chenxuuu/eink-calendar-server/shell.FCStd

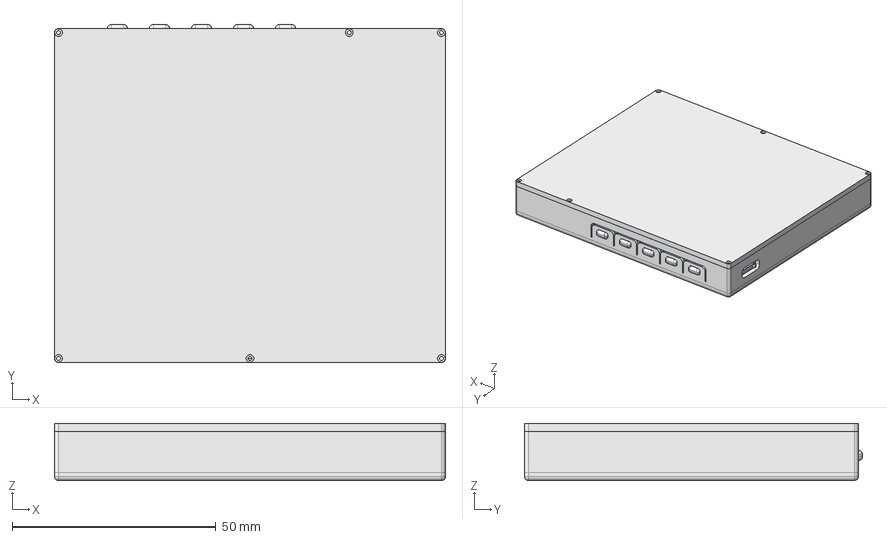
[picture p1: CAD file, 2021-05-28]
shell.FCStd
96.0 x 83.0 x 14.0 mm
under001
font001
