chenxuuu/eink-calendar-server/Eink-Air724/la-pi.kicad_pcb

## KiCad design Eink-Air724/la-pi.kicad_pcb (2021-07-12)

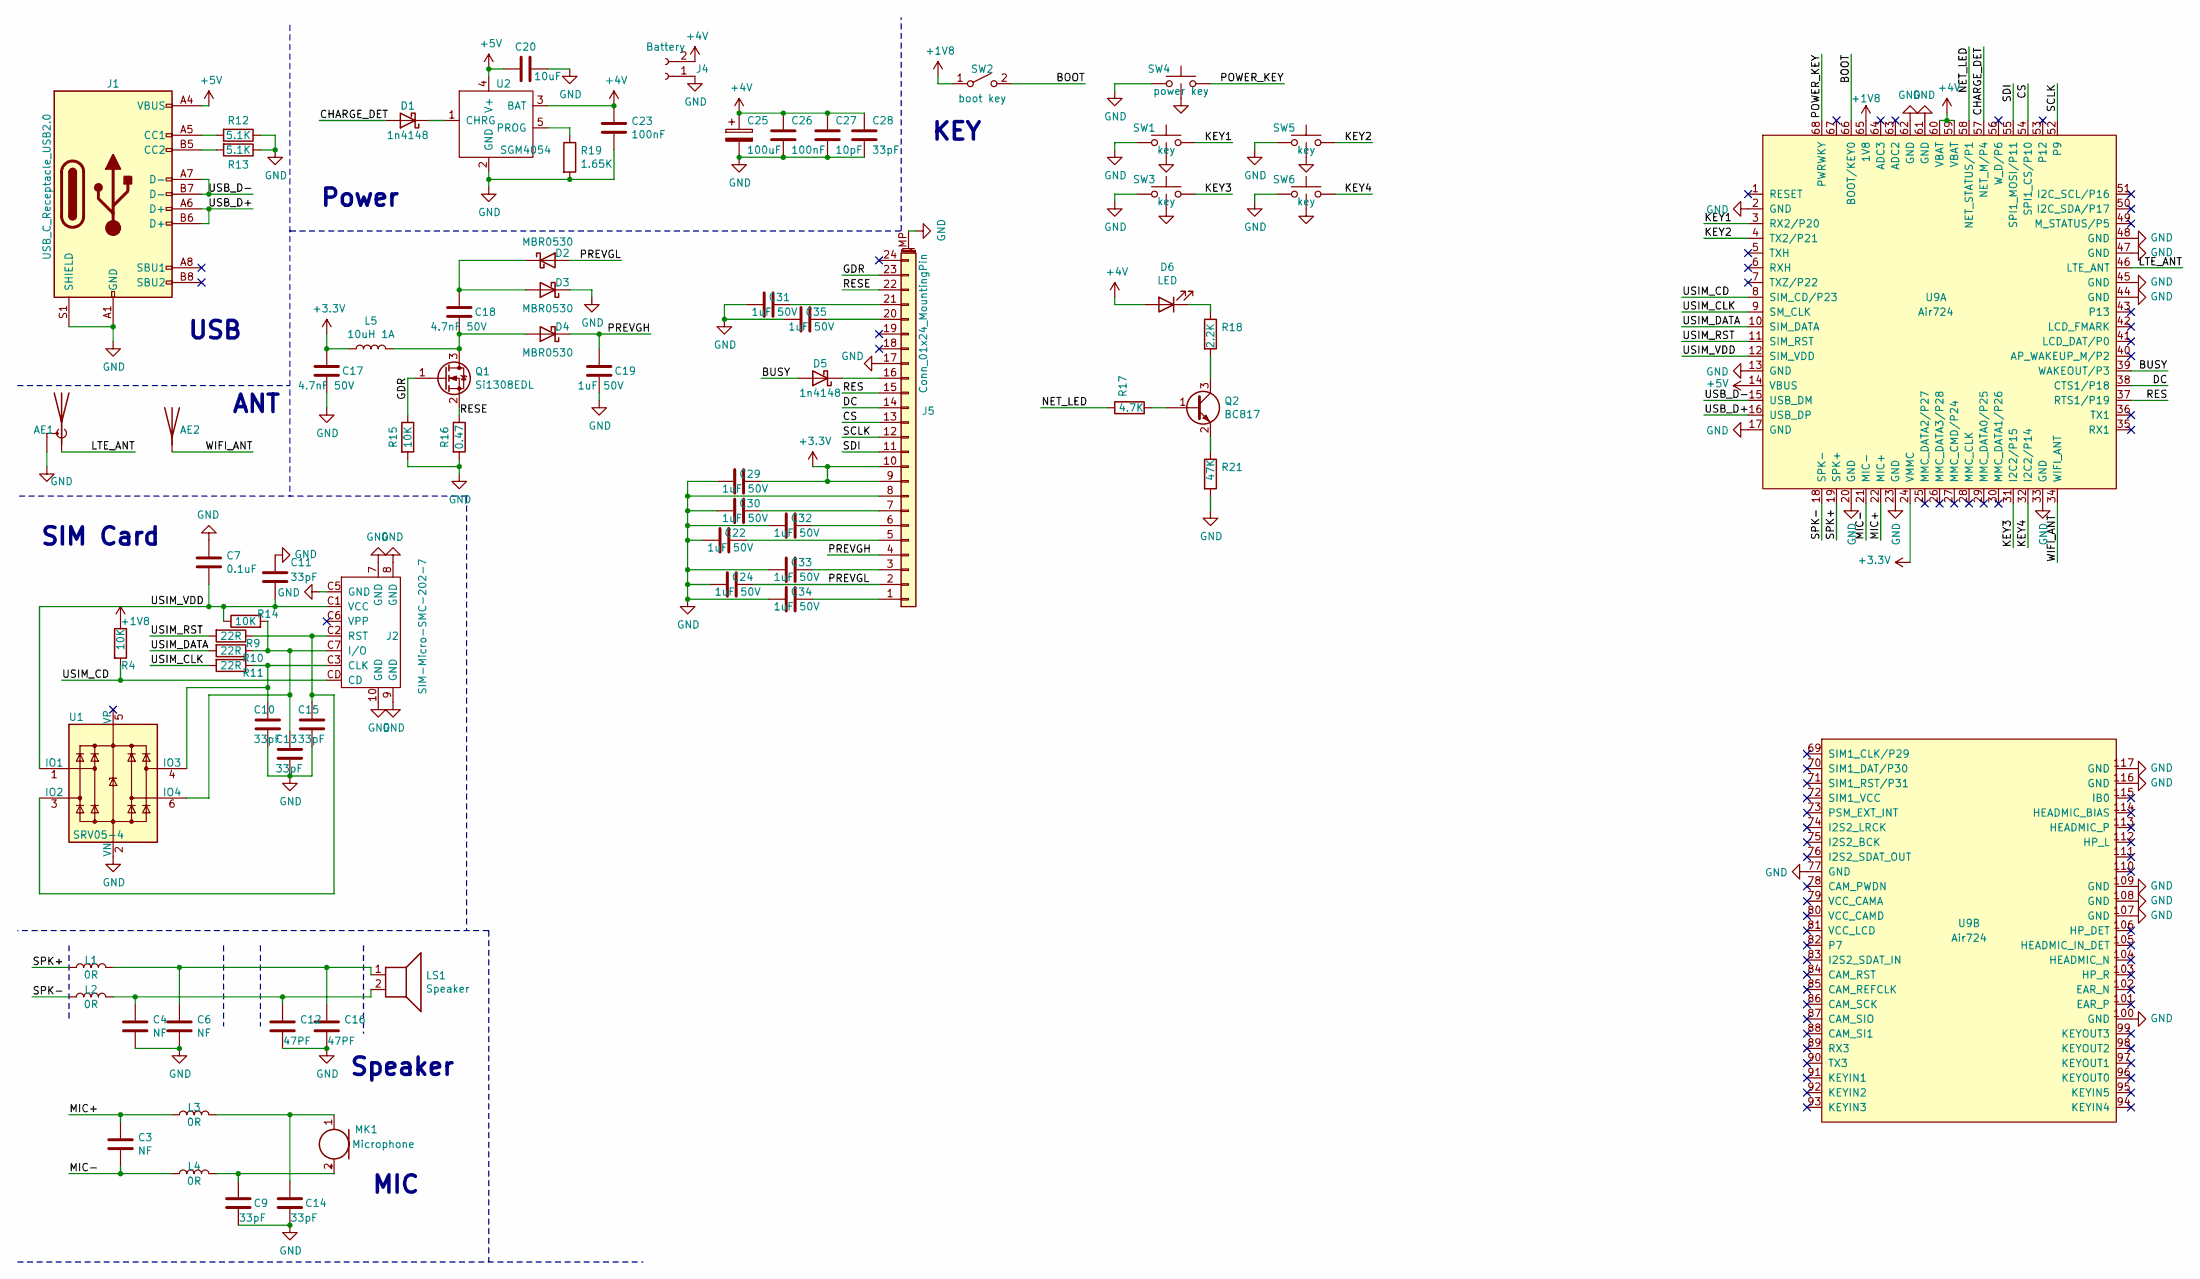
[picture p2: schematic la-pi.sch, La Pi]

Parts:
AE1: Antenna; IPEX
AE2: Antenna; Wifi_2.4GHz
C3, C4, C6: NF; C_0402_1005Metric
C7: 0.1uF; C_0402_1005Metric
C9, C10, C11, C13, C14, C15: 33pF; C_0402_1005Metric
C12, C16: 47PF; C_0402_1005Metric
C17, C18: 4.7nF 50V; C_0402_1005Metric
C19, C22, C24, C29, C30, C31, C32, C33, C34, C35: 1uF 50V; C_0402_1005Metric
C20: 10uF; C_0402_1005Metric
C23, C26: 100nF; C_0402_1005Metric
C25: 100uF; CP_EIA-1608-10_AVX-L_Pad1.25x1.05mm_HandSolder
C27: 10pF; C_0603_1608Metric
C28: 33pF; C_0603_1608Metric
D1, D5: 1n4148; D_SOD-323
D2, D3, D4: MBR0530; D_SOD-123
D6: LED; LED_0402_1005Metric
J1: USB_C_Receptacle_USB2.0; USB_C_Receptacle_HRO_TYPE-C-31-M-12
J2: SIM-Micro-SMC-202-7; SIM-SMD_SMC-202-7
J4: Battery; 2pin
J5: Conn_01x24_MountingPin; GDEW042T2
L1, L2, L3, L4: 0R; R_0402_1005Metric
L5: 10uH 1A; L_Bourns-SRN4018
LS1: Speaker; 2pin
MK1: Microphone; MIC-TH_BD4.0-P1.40-D0.4-L-FD
Q1: Si1308EDL; SOT-323_SC-70
Q2: BC817; SOT-23
R4, R14, R15: 10K; R_0402_1005Metric
R9, R10, R11: 22R; R_0402_1005Metric
R12, R13: 5.1K; R_0402_1005Metric
R16: 0.47; R_0402_1005Metric
R17: 4.7K; R_0402_1005Metric
R18: 2.2K; R_0402_1005Metric
R19: 1.65K; R_0402_1005Metric
R21: 47K; R_0402_1005Metric
SW1, SW3, SW5, SW6: key; KEY-01
SW2: boot key; 2pin
SW4: power key; KEY-01
U1: SRV05-4; SOT-23-6
U2: SGM4054; SOT-23-5
U9: Air724

Connections:
+1V8: R4.1, SW2.1 (A), U9.65 (1V8)
+3V3: C17.1, C29.2, J5.9, J5.10, L5.1, U9.24 (VMMC)
+4V: C23.1, C25.1, C26.1, C27.1, C28.1, D6.2 (A), J4.2, U2.3 (BAT), U9.59 (VBAT), U9.60 (VBAT)
+5V: C20.2, J1.A4 (VBUS), J1.A9 (VBUS), J1.B4 (VBUS), J1.B9 (VBUS), U2.4 (V+), U9.14 (VBUS)
/BOOT: SW2.2 (B), U9.66 (BOOT/KEY0)
/BUSY: D5.2 (A), U9.39 (WAKEOUT/P3)
/CHARGE_DET: D1.2 (A), U9.57 (NET_M/P4)
/CS: J5.13, U9.54 (SPI1_CS/P10)
/DC: J5.14, U9.38 (CTS1/P18)
/GDR: J5.23, Q1.1 (G), R15.1
/KEY1: SW1.2, U9.3 (RX2/P20)
/KEY2: SW5.2, U9.4 (TX2/P21)
/KEY3: SW3.2, U9.31 (I2C2/P15)
/KEY4: SW6.2, U9.32 (I2C2/P14)
/LTE_ANT: AE1.1 (A), U9.46 (LTE_ANT)
/MIC+: C3.1, L3.1, U9.22 (MIC+)
/MIC-: C3.2, L4.1, U9.21 (MIC-)
/NET_LED: R17.1, U9.58 (NET_STATUS/P1)
/POWER_KEY: SW4.2, U9.68 (PWRWKY)
/PREVGH: C19.1, D4.1 (K), J5.4
/PREVGL: C24.2, D2.2 (A), J5.2
/RES: J5.15, U9.37 (RTS1/P19)
/RESE: J5.22, Q1.2 (S), R16.1
/SCLK: J5.12, U9.52 (P9)
/SDI: J5.11, U9.55 (SPI1_MOSI/P11)
/SPK+: L1.1, U9.19 (SPK+)
/SPK-: L2.1, U9.18 (SPK-)
/USB_D+: J1.A6 (D+), J1.B6 (D+), U9.16 (USB_DP)
/USB_D-: J1.A7 (D-), J1.B7 (D-), U9.15 (USB_DM)
/USIM_CD: J2.CD, R4.2, U9.8 (SIM_CD/P23)
/USIM_CLK: R11.2, U9.9 (SM_CLK)
/USIM_DATA: R10.2, U9.10 (SIM_DATA)
/USIM_RST: R9.2, U9.11 (SIM_RST)
/USIM_VDD: C7.2, C11.2, J2.C1 (VCC), R14.1, U1.1 (IO1), U9.12 (SIM_VDD)
/WIFI_ANT: AE2.1, U9.34 (WIFI_ANT)
GND: AE1.2 (Shield), C4.2, C6.2, C7.1, C9.2, C10.2, C11.1, C12.2, C13.2, C14.2, C15.2, C16.2, C17.2, C19.2, C20.1, C22.1, C23.2, C24.1, C25.2, C26.2, C27.2, C28.2, C29.1, C30.1, C31.1, C32.1, C33.1, C34.1, C35.1, D3.1 (K), J1.A1 (GND), J1.A12 (GND), J1.B1 (GND), J1.B12 (GND), J1.S1 (SHIELD), J2.7 (GND), J2.8 (GND), J2.9 (GND), J2.10 (GND), J2.C5 (GND), J4.1, J5.8, J5.17, J5.MP (MountPin), R12.1, R13.1, R15.2, R16.2, R19.2, R21.2, SW1.1, SW1.3 (GND), SW3.1, SW3.3 (GND), SW4.1, SW4.3 (GND), SW5.1, SW5.3 (GND), SW6.1, SW6.3 (GND), U1.2 (VN), U2.2 (GND), U9.2 (GND), U9.13 (GND), U9.17 (GND), U9.20 (GND), U9.23 (GND), U9.33 (GND), U9.44 (GND), U9.45 (GND), U9.47 (GND), U9.48 (GND), U9.61 (GND), U9.62 (GND), U9.77 (GND), U9.100 (GND), U9.107 (GND), U9.108 (GND), U9.109 (GND), U9.116 (GND), U9.117 (GND)
unnamed: C9.1, L4.2, MK1.2 (+)
unnamed: C10.1, J2.C3 (CLK), R11.1, U1.4 (IO3)
unnamed: C4.1, C12.1, L2.2, LS1.2
unnamed: C13.1, J2.C7 (I/O), R10.1, R14.2, U1.6 (IO4)
unnamed: C14.1, L3.2, MK1.1 (-)
unnamed: C15.1, J2.C2 (RST), R9.1, U1.3 (IO2)
unnamed: C6.1, C16.1, L1.2, LS1.1
unnamed: C18.1, D2.1 (K), D3.2 (A)
unnamed: C18.2, D4.2 (A), L5.2, Q1.3 (D)
unnamed: C22.2, J5.5
unnamed: C30.2, J5.7
unnamed: C31.2, J5.21
unnamed: C32.2, J5.6
unnamed: C33.2, J5.3
unnamed: C34.2, J5.1
unnamed: C35.2, J5.20
unnamed: D1.1 (K), U2.1 (CHRG)
unnamed: D5.1 (K), J5.16
unnamed: D6.1 (K), R18.1
unnamed: J1.A5 (CC1), R12.2
unnamed: J1.B5 (CC2), R13.2
unnamed: Q2.1 (B), R17.2
unnamed: Q2.2 (E), R21.1
unnamed: Q2.3 (C), R18.2
unnamed: R19.1, U2.5 (PROG)

Notes on the sheet:
USB
Power
ANT
SIM Card
Speaker
MIC
KEY

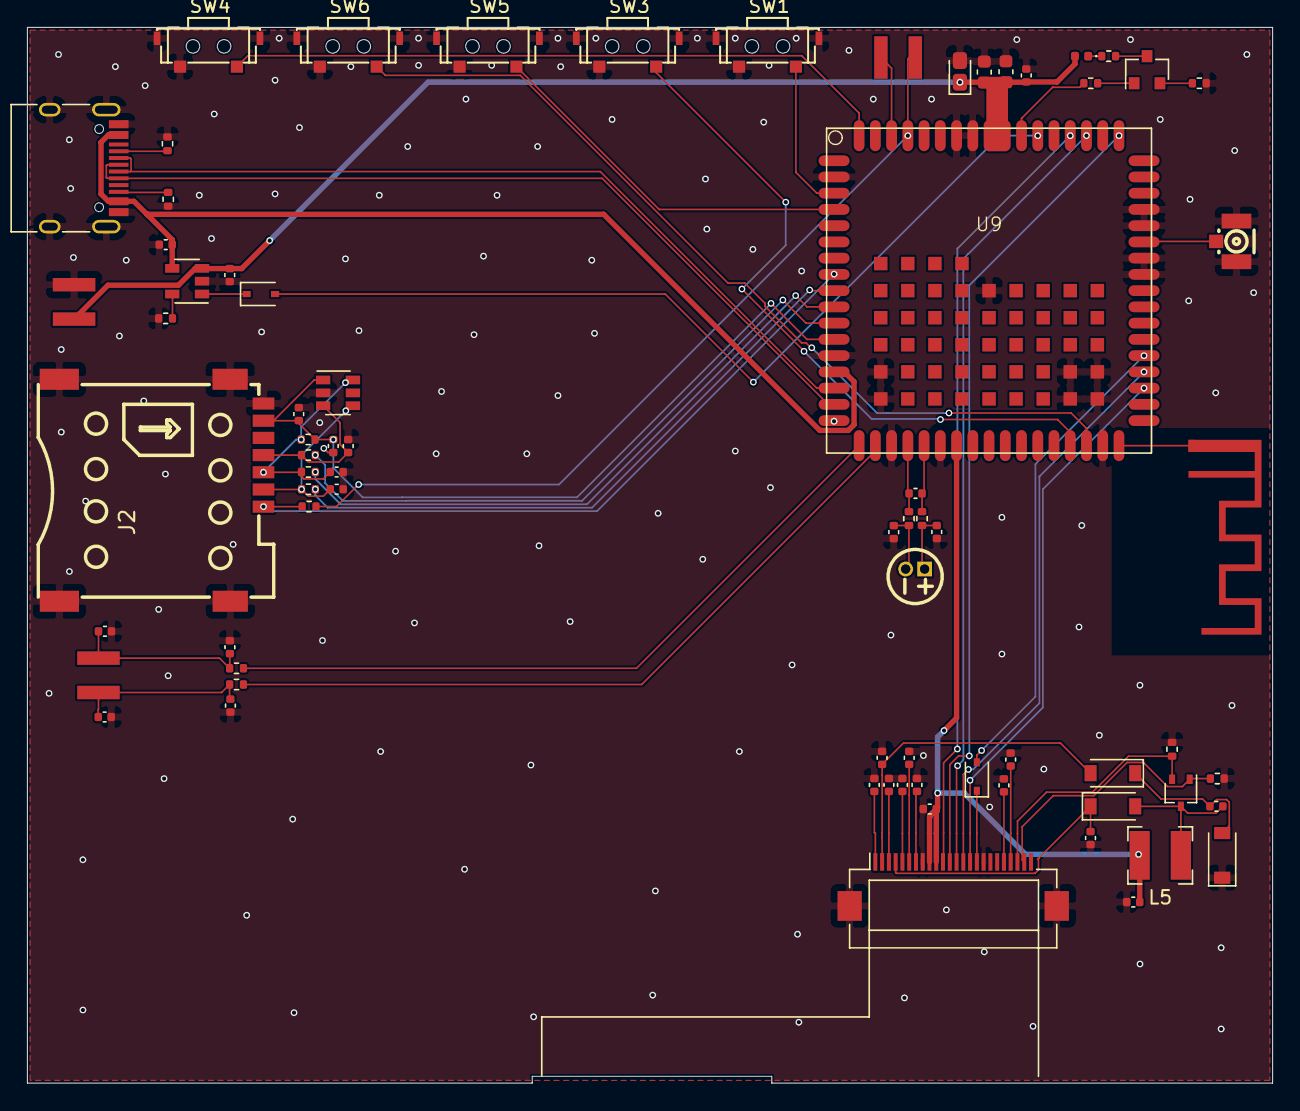
[picture p3: board la-pi.kicad_pcb from above]

Board: 2 copper layers, 92.0 x 78.0 mm, 73 parts (1 on the bottom side), 61 nets.
