chenxuuu/eink-calendar-server/eink_spi/main.lua

--必须在这个位置定义PROJECT和VERSION变量
--PROJECT：ascii string类型，可以随便定义，只要不使用,就行
--VERSION：ascii string类型，如果使用Luat物联云平台固件升级的功能，必须按照"X.X.X"定义，X表示1位数字；否则可随便定义
PROJECT = "EINK-CALENDAR"
VERSION = "1.0.3"

--加载日志功能模块，并且设置日志输出等级
--如果关闭调用log模块接口输出的日志，等级设置为log.LOG_SILENT即可
require "log"
LOG_LEVEL = log.LOGLEVEL_TRACE
--[[
如果使用UART输出日志，打开这行注释的代码"--log.openTrace(true,1,115200)"即可，根据自己的需求修改此接口的参数
如果要彻底关闭脚本中的输出日志（包括调用log模块接口和Lua标准print接口输出的日志），执行log.openTrace(false,第二个参数跟调用openTrace接口打开日志的第二个参数相同)，例如：
1、没有调用过sys.opntrace配置日志输出端口或者最后一次是调用log.openTrace(true,nil,921600)配置日志输出端口，此时要关闭输出日志，直接调用log.openTrace(false)即可
2、最后一次是调用log.openTrace(true,1,115200)配置日志输出端口，此时要关闭输出日志，直接调用log.openTrace(false,1)即可
]]
--log.openTrace(true,1,115200)

require "sys"

require "net"
--每1分钟查询一次GSM信号强度
--每1分钟查询一次基站信息
net.startQueryAll(60000, 60000)

--此处关闭RNDIS网卡功能
--否则，模块通过USB连接电脑后，会在电脑的网络适配器中枚举一个RNDIS网卡，电脑默认使用此网卡上网，导致模块使用的sim卡流量流失
--如果项目中需要打开此功能，把ril.request("AT+RNDISCALL=0,1")修改为ril.request("AT+RNDISCALL=1,1")即可
--注意：core固件：V0030以及之后的版本、V3028以及之后的版本，才以稳定地支持此功能
ril.request("AT+RNDISCALL=0,1")

--加载网络指示灯功能模块
--根据自己的项目需求和硬件配置决定：1、是否加载此功能模块；2、配置指示灯引脚
--合宙官方出售的Air720U开发板上的网络指示灯引脚为pio.P0_1，LTE指示灯引脚为pio.P0_4
require "netLed"
pmd.ldoset(7,pmd.LDO_VLCD)
netLed.setup(true,pio.P0_1)
--网络指示灯功能模块中，默认配置了各种工作状态下指示灯的闪烁规律，参考netLed.lua中ledBlinkTime配置的默认值
--如果默认值满足不了需求，此处调用netLed.updateBlinkTime去配置闪烁时长

require"nvm"
require"config"
nvm.init("config.lua")

--加载错误日志管理功能模块【强烈建议打开此功能】
--如下2行代码，只是简单的演示如何使用errDump功能，详情参考errDump的api
require "errDump"
errDump.request("udp://ota.airm2m.com:9072")

--加载远程升级功能模块【强烈建议打开此功能】
--如下3行代码，只是简单的演示如何使用update功能，详情参考update的api以及demo/update
PRODUCT_KEY = "a79KxY1I3CJ5m6KymLWLfYZGn0lcqNZz"
require "update"
update.request()


local function alarMsg()
	print("alarMsg")
end
--如果是关机闹钟开机，则需要软件主动重启一次，才能启动GSM协议栈
if rtos.poweron_reason()==rtos.POWERON_ALARM then
	sys.restart("ALARM")
end
--注册闹钟模块
rtos.init_module(rtos.MOD_ALARM)
--注册闹钟消息的处理函数（如果是开机闹钟，闹钟事件到来时会调用alarmsg）
rtos.on(rtos.MSG_ALARM,alarMsg)

--加载SPI接口的功能测试模块
require "eink"

--启动系统框架
sys.init(0, 0)
sys.run()
