chenxuuu/eink-calendar-server/(commit log)

2021-05-18 能跑起来了
2021-05-19 字体文件拎出来，用io加载，不编译进代码了，太慢了
2021-05-19 测试下webhook管不管用
2021-05-19 测试路由改下，继续试webhook
2021-05-19 更正数位序，多加点字，顺便再测试下webhook
2021-05-20 天气接口换成新的
2021-05-20 可以显示天气了
2021-05-20 日历功能好了
2021-05-20 加上一言的接口
2021-05-20 更正电量显示问题
2021-05-20 上传模块lua代码
2021-05-20 支持灰度或黑白设置
2021-05-21 微调下代码
2021-05-21 加上温度显示
2021-05-21 调整下位置
2021-05-21 刷新时间改成一天三次
2021-05-21 诗词分割两行居中处理
2021-05-24 加个开机画面
2021-05-24 刷屏有点问题，改下
2021-05-24 微调下电量
2021-05-24 🔋图案的头往上一个像素
2021-05-28 添加外壳文件
    [shell.FCStd]
2021-06-07 八点前就不显示一言了，不然浪费电
2021-06-17 改回去。。
2021-06-27 当一言炸了的时候，显示默认文本
2021-07-06 加上自定义文本功能
2021-07-06 字多了改小字
2021-07-12 硬件工程
    [la-pi.kicad_pcb, la-pi.sch]
2021-12-09 fix: 更正找不到图标时报错的问题
2021-12-17 add: 补两张图片
